AnderssonL/rocket-guidance-hardware/design/ACS_PCB.kicad_pcb

## KiCad design design/ACS_PCB.kicad_pcb (2025-10-14)

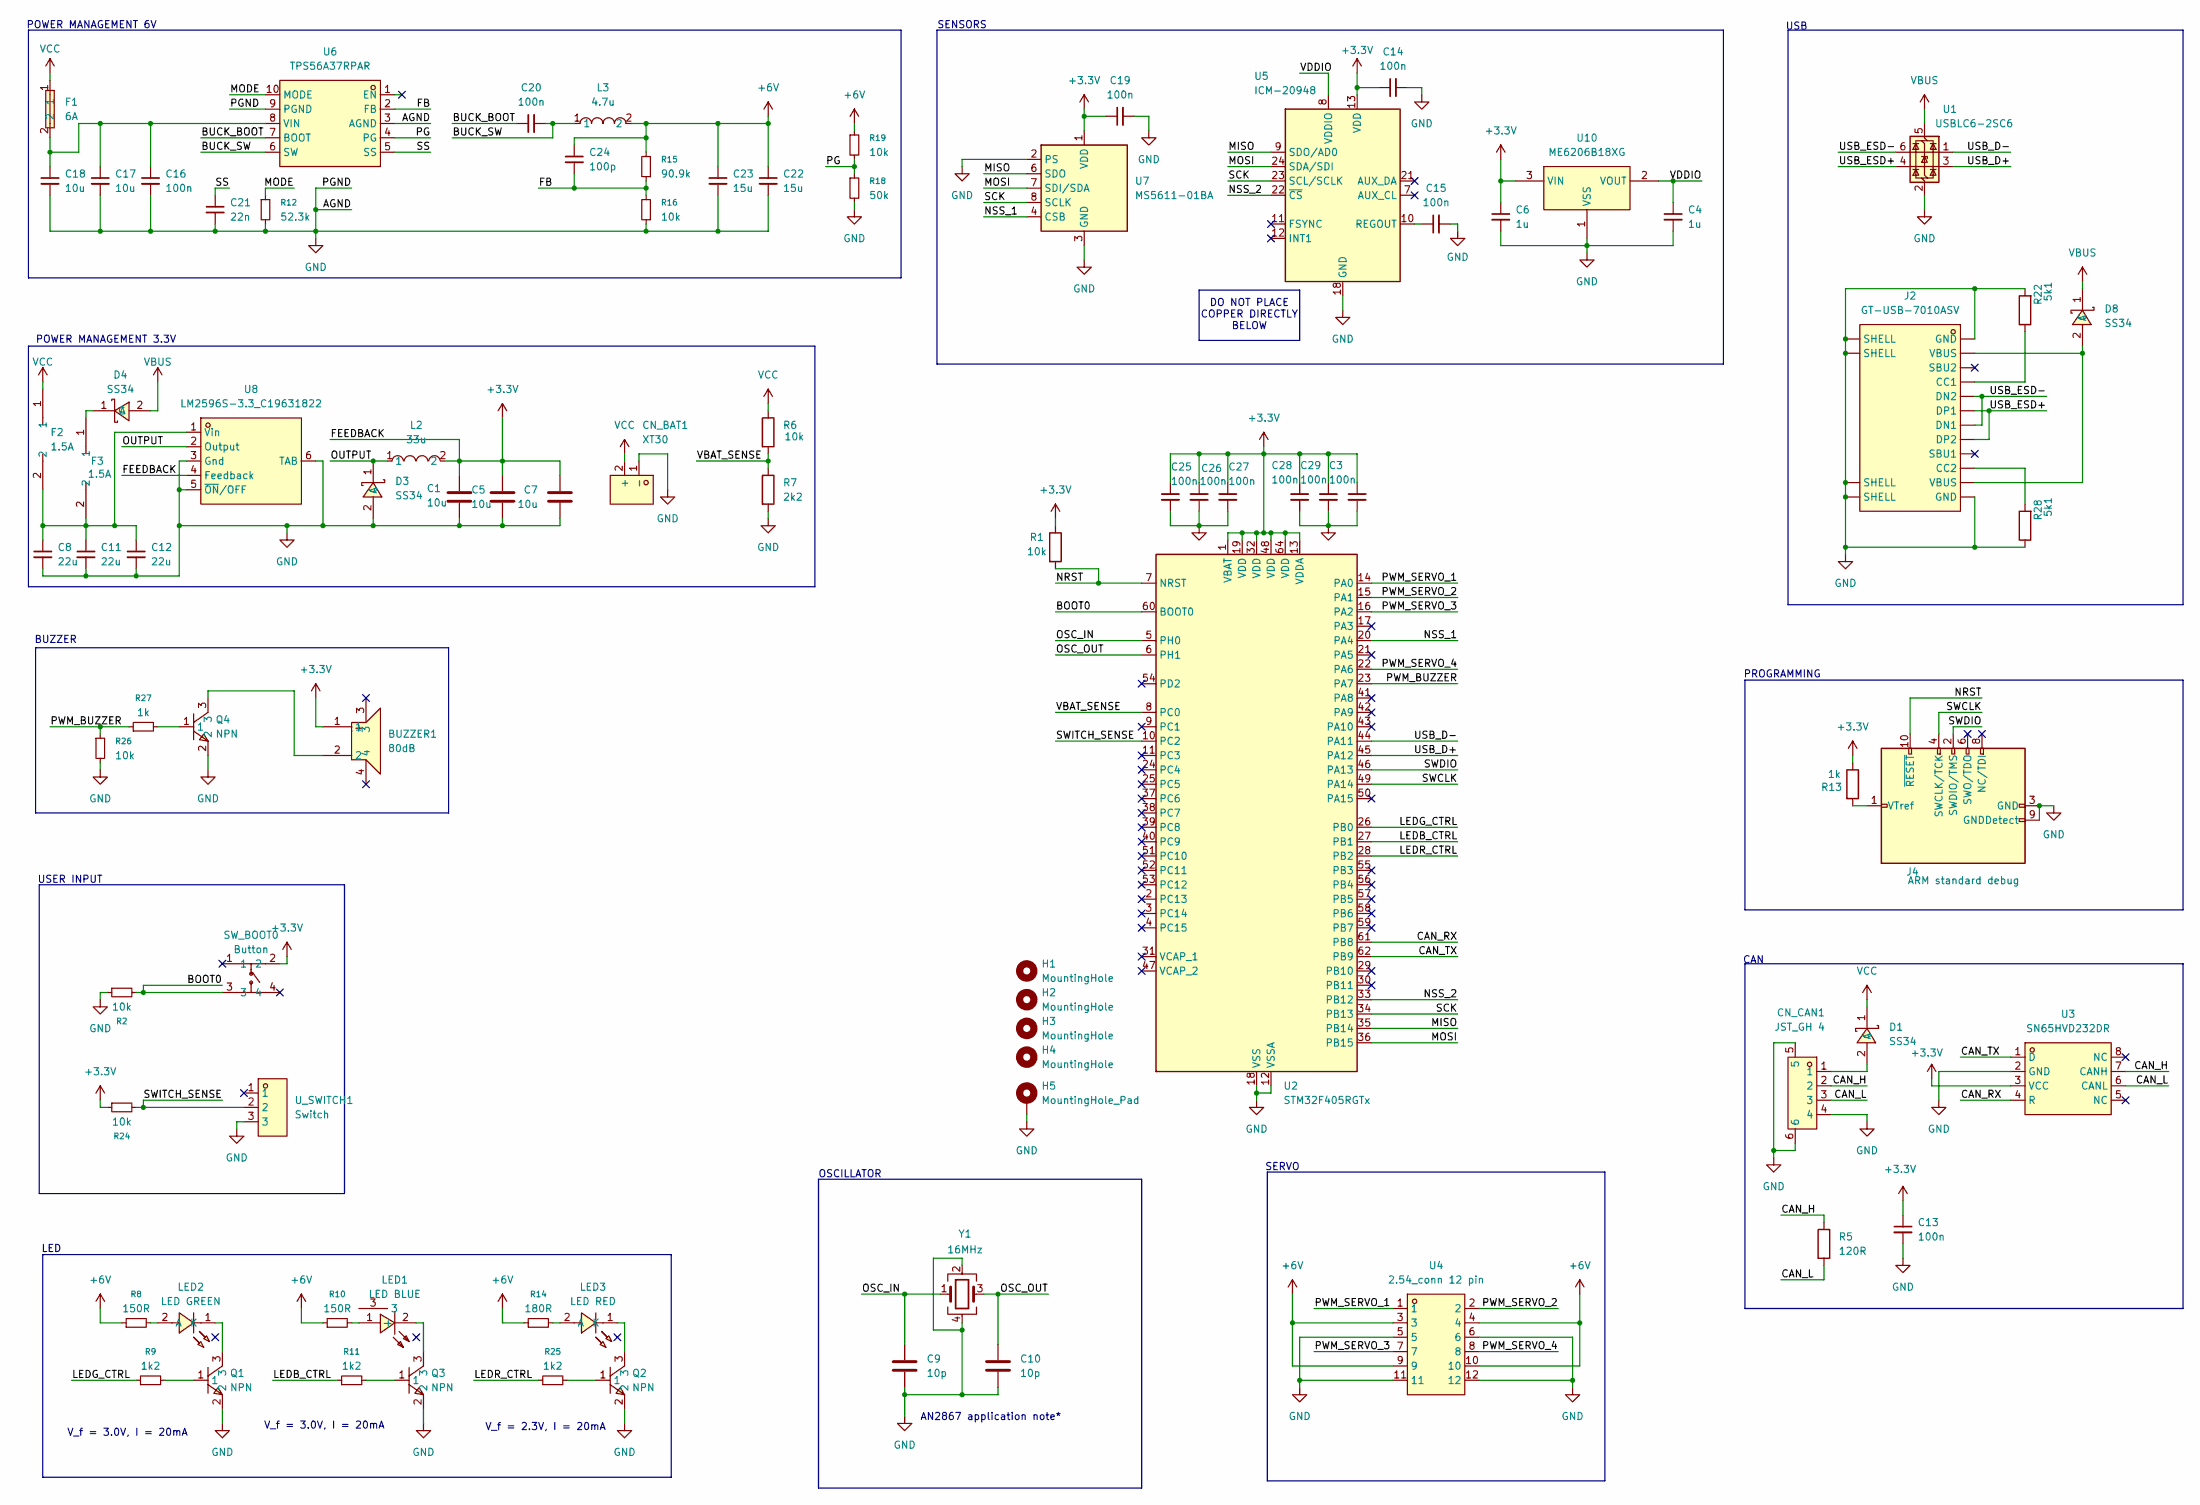
[picture p1: schematic ACS_PCB.kicad_sch]

Parts:
BUZZER1: 80dB; BUZ-SMD_4P-L7.5-W7.5-BR; LCSC Part C49246950
C1, C5, C7: 10u; C_0201_0603Metric; LCSC Part C19702
C3, C13, C14, C15, C16, C19, C20, C25, C26, C27, C28, C29: 100n; C_0603_1608Metric; LCSC Part C14663
C4, C6: 1u; C_0603_1608Metric; LCSC Part C15849
C8, C11, C12: 22u; C_0603_1608Metric; LCSC Part C2762594
C9, C10: 10p; C_0603_1608Metric; LCSC Part C1634
C17, C18: 10u; C_0603_1608Metric; LCSC Part C19702
C21: 22n; C_0603_1608Metric; LCSC Part C21122
C22, C23: 15u; C_0603_1608Metric; LCSC Part C445715
C24: 100p; C_0603_1608Metric; LCSC Part C14858
CN_BAT1: XT30; CONN-TH_XT30UPB-M; LCSC Part C428721
CN_CAN1: JST_GH 4; CONN-SMD_4P-P1.25_JXTCONN_DMX-4PWB-43; LCSC Part C42422450
D1, D3, D4, D8: SS34; SMC_L6.9-W5.9-LS7.9-RD; LCSC Part C154551
F1: 6A; F1812; LCSC Part C7542974
F2, F3: 1.5A; F1812; LCSC Part C70117
H1, H2, H3, H4: MountingHole; SMD_BD4.0-D2.5_TH162030CTJ; LCSC Part C3020127
H5: MountingHole_Pad; MountingHole_2.2mm_M2_DIN965_Pad
J2: GT-USB-7010ASV; USB-C-SMD_G-SWITCH_GT-USB-7010ASV; LCSC Part C2988369
J4: ARM standard debug; HDR-SMD_10P-P1.27-V-R2-C5-S5.8; LCSC Part C5155080
L2: 33u; IND-SMD_L6.8-W6.8_SMMS0630; LCSC Part C149577
L3: 4.7u; L0603; LCSC Part C114862
LED1: LED BLUE; LED-SMD_L3.2-W1.0-R-RD; LCSC Part C375481
LED2: LED GREEN; LED1206-RD_GREEN-SIDE; LCSC Part C375564
LED3: LED RED; LED1206-RD_RED_XL-3216SURC-FB; LCSC Part C3646938
Q1, Q2, Q3, Q4: NPN; SOT-23-3_L2.9-W1.3-P1.90-LS2.4-BR; LCSC Part C57668
R1, R2, R6, R16, R19, R24, R26: 10k; R_0603_1608Metric; LCSC Part C98220
R5: 120R; R_0603_1608Metric; LCSC Part C22787
R7: 2k2; R_0603_1608Metric; LCSC Part C114662
R8, R10: 150R; R_0603_1608Metric; LCSC Part C2907103
R9, R11, R25: 1k2; R_0603_1608Metric; LCSC Part C2906976
R12: 52.3k; R_0603_1608Metric; LCSC Part C2998074
R13, R27: 1k; R_0603_1608Metric; LCSC Part C22548
R14: 180R; R_0603_1608Metric; LCSC Part C2907000
R15: 90.9k; R_0603_1608Metric; LCSC Part C2930136
R18: 50k; R_0603_1608Metric; LCSC Part C861451
R22, R28: 5k1; R_0603_1608Metric; LCSC Part C2907044
SW_BOOT0: Button; SW-SMD_4P-L5.2-W5.2-P3.70-LS6.4; LCSC Part C49234134
U1: USBLC6-2SC6; SOT-23-6_L2.9-W1.6-P0.95-LS2.8-BL; LCSC Part C7519
U2: STM32F405RGTx; LQFP-64_10x10mm_P0.5mm; LCSC Part C15742
U3: SN65HVD232DR; SOIC-8_L5.0-W4.0-P1.27-LS6.0-BL; LCSC Part C30530
U4: 2.54_conn 12 pin; HDR-TH_12P-P2.54-V-M-R2-C6-S2.54; LCSC Part C7501277
U5: ICM-20948; InvenSense_QFN-24_3x3mm_P0.4mm
U6: TPS56A37RPAR; VQFN-HR-10_L3.0-W3.0_TI_RPA; LCSC Part C22392669
U7: MS5611-01BA; SENSORS-SMD_MS5611-01BA03; LCSC Part C15639
U8: LM2596S-3.3_C19631822; TO-263-5_L10.2-W9.0-P1.70-TL-LS15.2; LCSC Part C19631822
U10: ME6206B18XG; SOT-23-3_L2.9-W1.3-P1.90-LS2.4-BR; LCSC Part C2683407
U_SWITCH1: Switch; SW-TH_MT-0-102-E001-T000-RS-PJ; LCSC Part C1788499
Y1: 16MHz; CRYSTAL-SMD_4P-L3.2-W2.5-BL; LCSC Part C112972

Connections:
+3.3V: BUZZER1.1, C1.1, C3.1, C5.1, C6.1, C7.1, C13.1, C14.1, C19.1, C25.1, C26.1, C27.1, C28.1, C29.1, L2.2, R1.1, R13.1, R24.1, SW_BOOT0.2, U2.1 (VBAT), U2.13 (VDDA), U2.19 (VDD), U2.32 (VDD), U2.48 (VDD), U2.64 (VDD), U3.3 (VCC), U5.13 (VDD), U7.1 (VDD), U8.4 (Feedback), U10.3 (VIN)
+6V: C22.1, C23.1, C24.1, L3.2, R8.1, R10.1, R14.1, R15.2, R19.1, U4.3, U4.4, U4.9, U4.10
/BOOT0: R2.2, SW_BOOT0.3, U2.60 (BOOT0)
/BUCK_BOOT: C20.1, U6.7 (BOOT)
/BUCK_SW: C20.2, L3.1, U6.6 (SW)
/CAN_H: CN_CAN1.2, R5.1, U3.7 (CANH)
/CAN_L: CN_CAN1.3, R5.2, U3.6 (CANL)
/CAN_RX: U2.61 (PB8), U3.4 (R)
/CAN_TX: U2.62 (PB9), U3.1 (D)
/FB: C24.2, R15.1, R16.2, U6.2 (FB)
/LEDB_CTRL: R11.1, U2.27 (PB1)
/LEDG_CTRL: R9.1, U2.26 (PB0)
/LEDR_CTRL: R25.1, U2.28 (PB2)
/MISO: U2.35 (PB14), U5.9 (SDO/AD0), U7.6 (SDO)
/MODE: R12.1, U6.10 (MODE)
/MOSI: U2.36 (PB15), U5.24 (SDA/SDI), U7.7 (SDI/SDA)
/NRST: J4.10 (~RESET), R1.2, U2.7 (NRST)
/NSS_1: U2.20 (PA4), U7.4 (CSB), U7.5 (CSB)
/NSS_2: U2.33 (PB12), U5.22 (~CS)
/OSC_IN: C9.1, U2.5 (PH0), Y1.1
/OSC_OUT: C10.1, U2.6 (PH1), Y1.3
/OUTPUT: D3.1 (C), L2.1, U8.2 (Output)
/PG: R18.1, R19.2, U6.4 (PG)
/PWM_BUZZER: R26.1, R27.1, U2.23 (PA7)
/PWM_SERVO_1: U2.14 (PA0), U4.1
/PWM_SERVO_2: U2.15 (PA1), U4.2
/PWM_SERVO_3: U2.16 (PA2), U4.7
/PWM_SERVO_4: U2.22 (PA6), U4.8
/SCK: U2.34 (PB13), U5.23 (SCL/SCLK), U7.8 (SCLK)
/SS: C21.1, U6.5 (SS)
/SWCLK: J4.4 (SWCLK/TCK), U2.49 (PA14)
/SWDIO: J4.2 (SWDIO/TMS), U2.46 (PA13)
/SWITCH_SENSE: R24.2, U2.10 (PC2), U_SWITCH1.2
/USB_D+: U1.3 (I/O2), U2.45 (PA12)
/USB_D-: U1.1 (I/O1), U2.44 (PA11)
/USB_ESD+: J2.A6 (DP1), J2.B6 (DP2), U1.4 (I/O2)
/USB_ESD-: J2.A7 (DN1), J2.B7 (DN2), U1.6 (I/O1)
/VBAT_SENSE: R6.2, R7.1, U2.8 (PC0)
/VDDIO: C4.1, U5.8 (VDDIO), U10.2 (VOUT)
GND: C1.2, C3.2, C4.2, C5.2, C6.2, C7.2, C8.2, C9.2, C10.2, C11.2, C12.2, C13.2, C14.2, C15.2, C16.2, C17.2, C18.2, C19.2, C21.2, C22.2, C23.2, C25.2, C26.2, C27.2, C28.2, C29.2, CN_BAT1.1 (-), CN_CAN1.4, CN_CAN1.5, CN_CAN1.6, D3.2 (A), H5.1, J2.1 (SHELL), J2.2 (SHELL), J2.3 (SHELL), J2.4 (SHELL), J2.A1B12 (GND), J2.B1A12 (GND), J4.3 (GND), J4.5 (GND), J4.9 (GNDDetect), Q1.2, Q2.2, Q3.2, Q4.2, R2.1, R7.2, R12.2, R16.1, R18.2, R22.2, R26.2, R28.1, U1.2 (GND), U2.12 (VSSA), U2.18 (VSS), U2.63 (VSS), U3.2 (GND), U4.5, U4.6, U4.11, U4.12, U5.18 (GND), U5.20 (GND), U6.3 (AGND), U6.9 (PGND), U7.2 (PS), U7.3 (GND), U8.3 (Gnd), U8.5 (~ON/OFF), U8.6 (TAB), U10.1 (VSS), U_SWITCH1.3, Y1.2, Y1.4
unnamed: BUZZER1.2, Q4.3
unnamed: CN_CAN1.1, D1.2 (A)
unnamed: D4.1 (C), F3.1
unnamed: D8.2 (A), J2.A4B9 (VBUS), J2.B4A9 (VBUS)
unnamed: J2.A5 (CC1), R22.1
unnamed: J2.B5 (CC2), R28.2
unnamed: J4.1 (VTref), R13.2
unnamed: LED1.1 (+), R10.2
unnamed: LED1.2 (-), Q3.3
unnamed: LED2.2 (A), R8.2
unnamed: LED2.1 (K), Q1.3
unnamed: LED3.2 (A), R14.2
unnamed: LED3.1 (K), Q2.3
unnamed: Q1.1, R9.2
unnamed: Q2.1, R25.2
unnamed: Q3.1, R11.2
unnamed: Q4.1, R27.2
unnamed: C15.1, U5.10 (REGOUT)
unnamed: C16.1, C17.1, C18.1, F1.2, U6.8 (VIN)
unnamed: C8.1, C11.1, C12.1, F2.2, F3.2, U8.1 (Vin)
VBUS: D4.2 (A), D8.1 (C), U1.5 (VBUS)
VCC: CN_BAT1.2 (+), D1.1 (C), F1.1, F2.1, R6.1

Notes on the sheet:
V_f = 3.0V, I = 20mA
BUZZER
SENSORS
USER INPUT
V_f = 2.3V, I = 20mA
LED
POWER MANAGEMENT 6V
POWER MANAGEMENT 3.3V
DO NOT PLACE COPPER DIRECTLY BELOW
OSCILLATOR
SERVO
USB
AN2867 application note*
CAN
PROGRAMMING

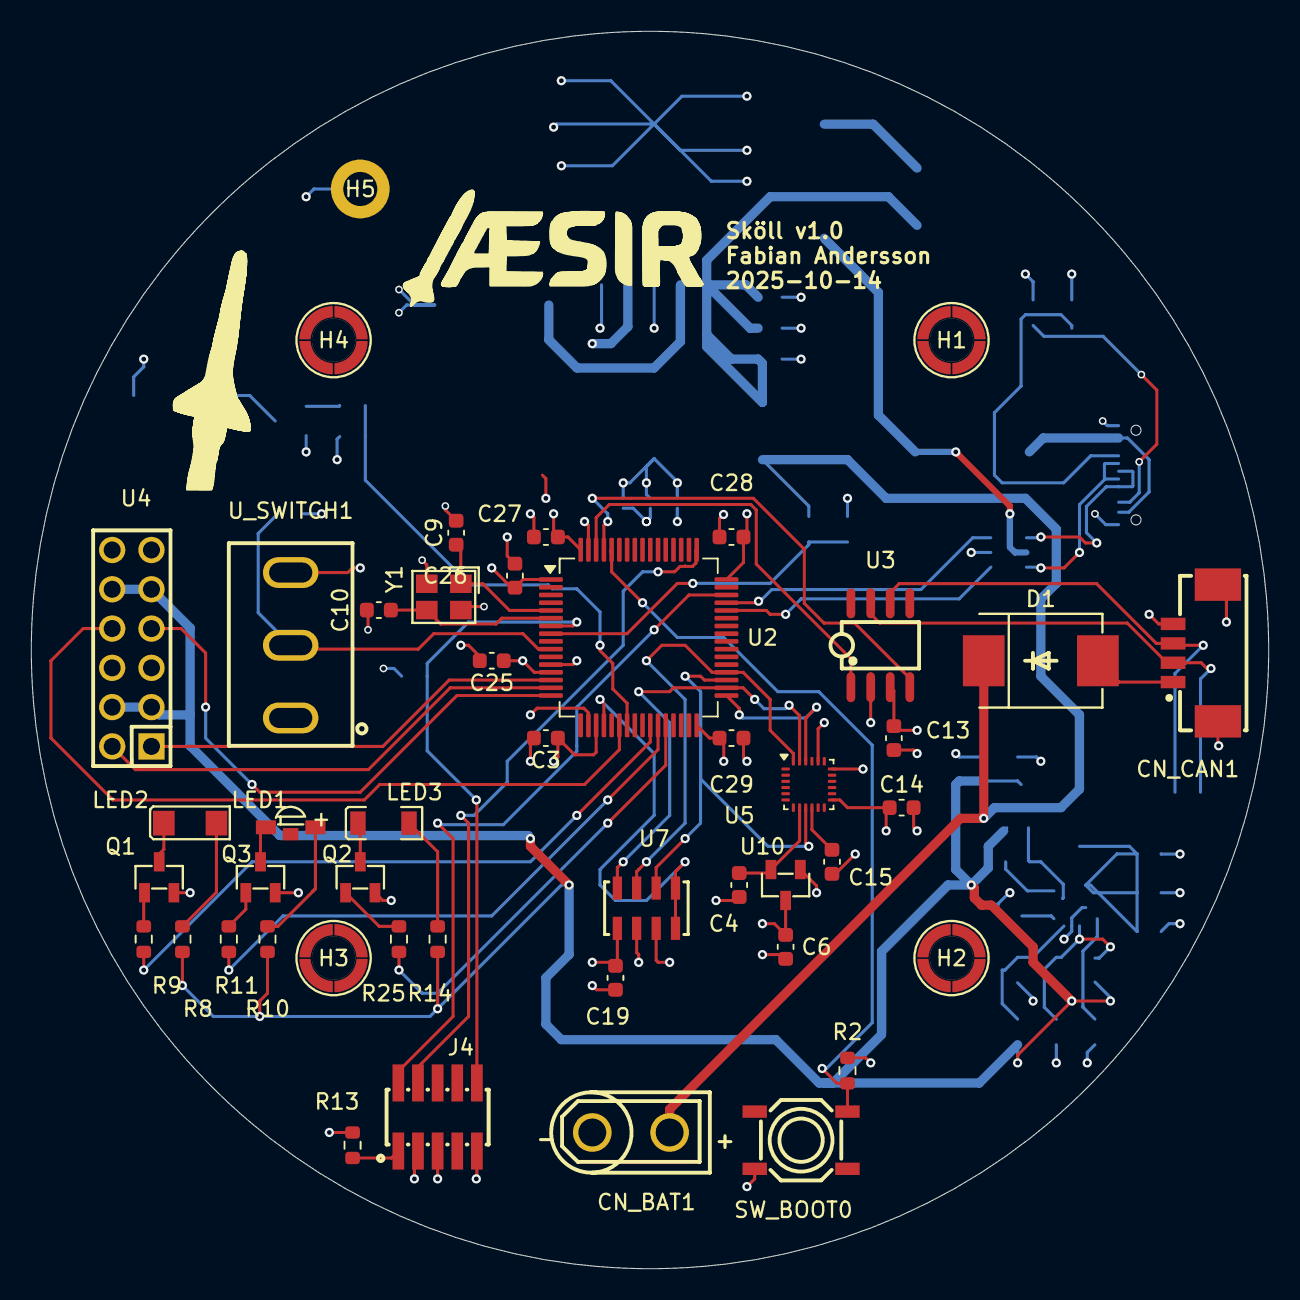
[picture p2: board ACS_PCB.kicad_pcb from above]

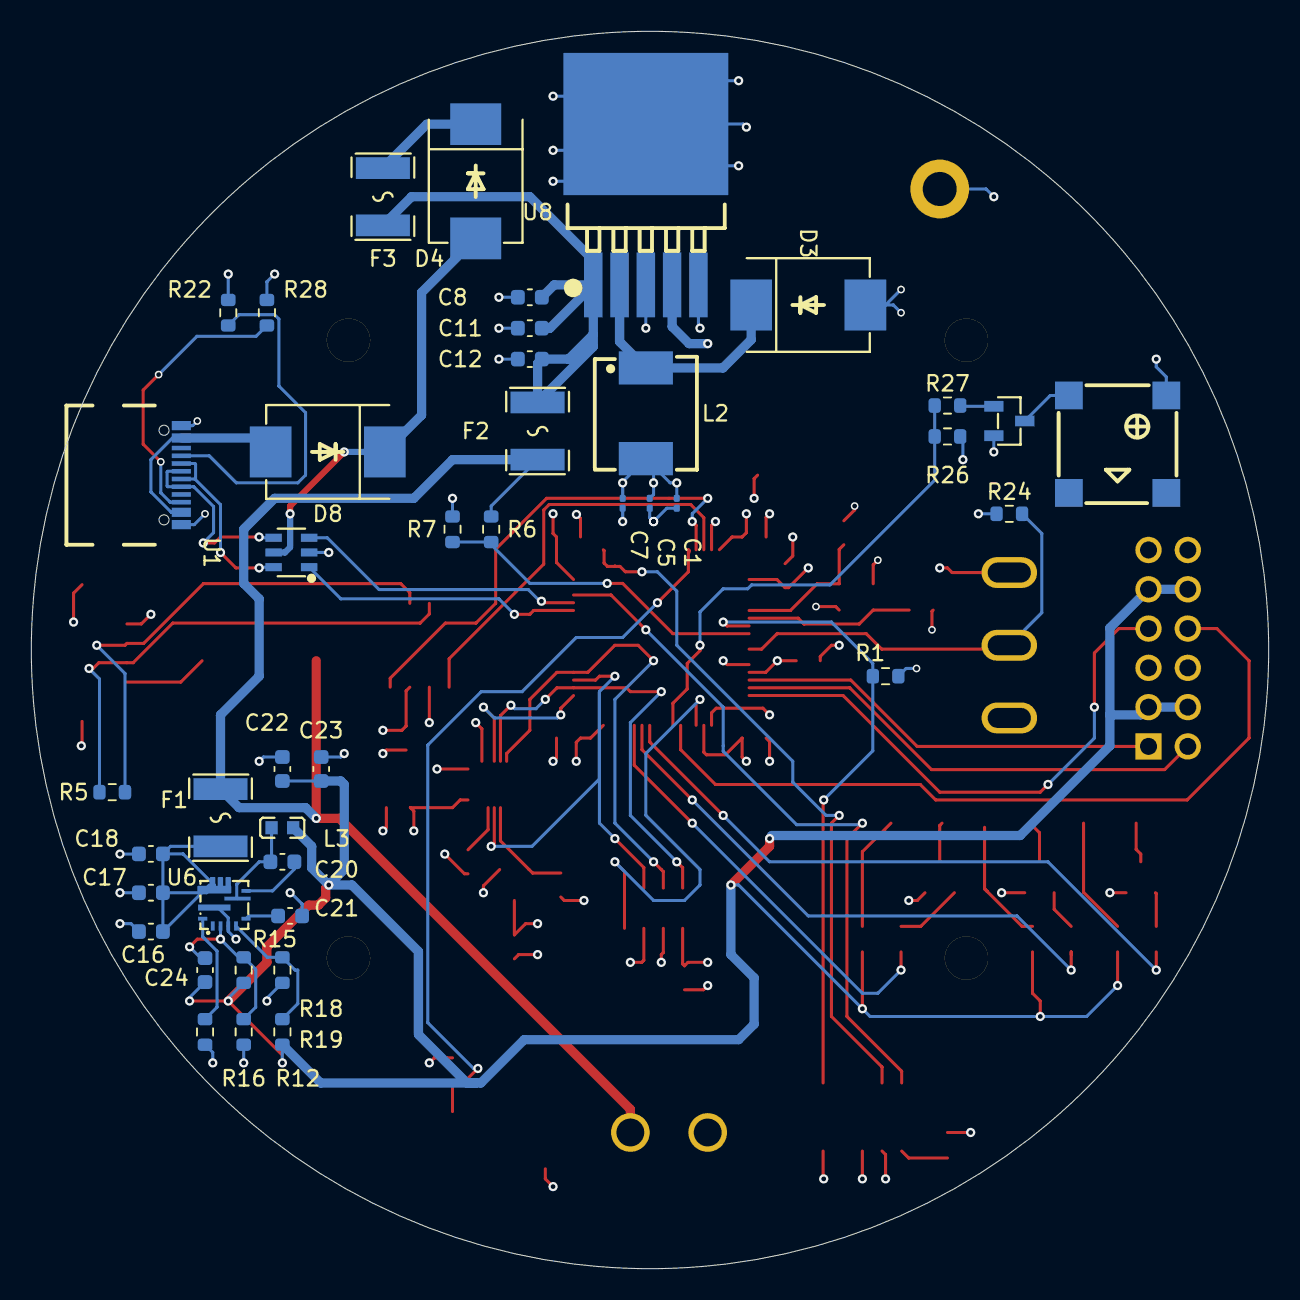
[picture p3: board ACS_PCB.kicad_pcb from below]

Board: 4 copper layers, 80.0 x 80.0 mm, 88 parts (42 on the bottom side), 62 nets.
