AnderssonL/rocket-guidance-hardware/(commit log)

2025-10-09 added design folder
    [ACS_PCB.kicad_pcb, ACS_PCB.kicad_sch]
2025-10-10 added buzzer, xt30, leds
    [ACS_PCB.kicad_sch]
2025-10-11 added sensors, switch, mounting hole, servo...
    [ACS_PCB.kicad_sch]
2025-10-12 selected LCSC components, small fixes.
    [ACS_PCB.kicad_pcb, ACS_PCB.kicad_sch]
2025-10-12 fixed things noted in design review
    [ACS_PCB.kicad_sch]
2025-10-12 placement stuff
    [ACS_PCB.kicad_pcb, ACS_PCB.kicad_sch]
2025-10-14 finished layout
    [ACS_PCB.kicad_pcb, ACS_PCB.kicad_sch]
2025-10-14 fixed silkscreen texts
    [ACS_PCB.kicad_pcb]
2025-10-14 added graphics
    [ACS_PCB.kicad_pcb]
2025-10-14 changed to 4 layers
    [ACS_PCB.kicad_pcb]
2025-10-14 fixed layout review things (ish)
    [ACS_PCB.kicad_pcb]
2025-10-14 fixed some of the suggestions by reviewers
    [ACS_PCB.kicad_pcb]
